maanika/mixed-signal-board/mixed_signal_demo.kicad_pcb

## KiCad design mixed_signal_demo.kicad_pcb (2025-05-20)

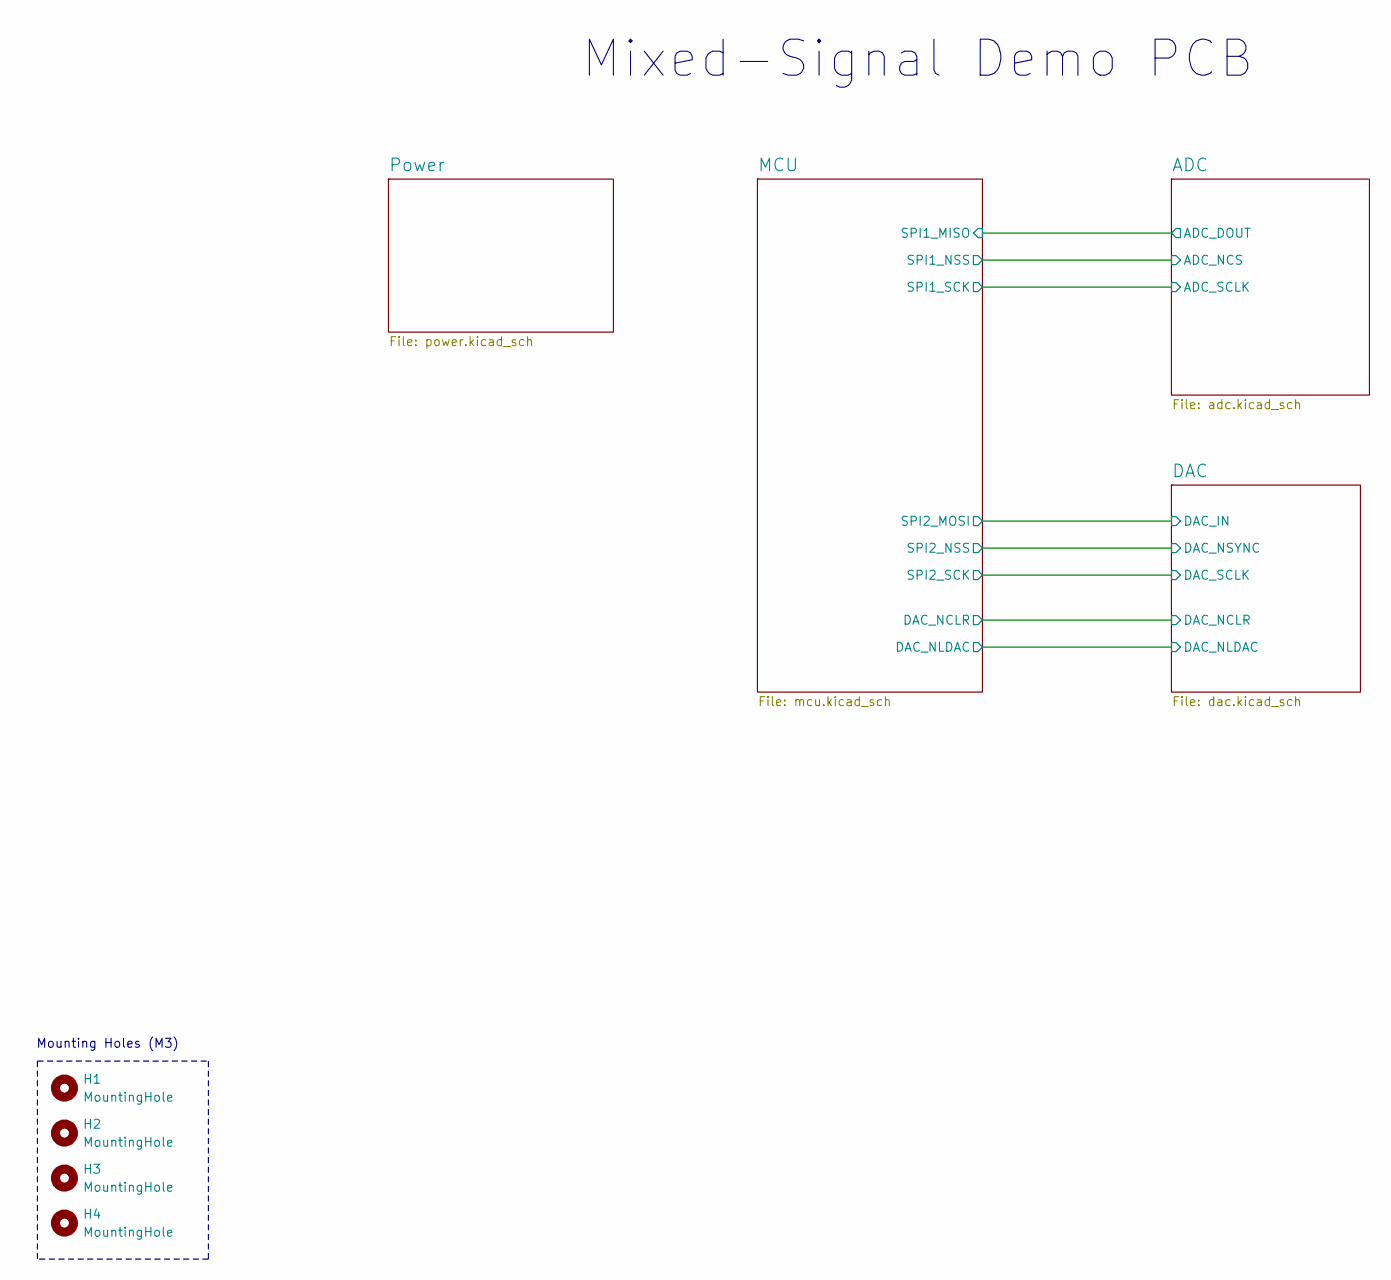
[picture p6: schematic mixed_signal_demo.kicad_sch, Mixed-Signal Demo PCB]

Parts:
H1, H2, H3, H4: MountingHole; MountingHole_3.2mm_M3

Notes on the sheet:
Mixed-Signal Demo PCB
Mounting Holes (M3)

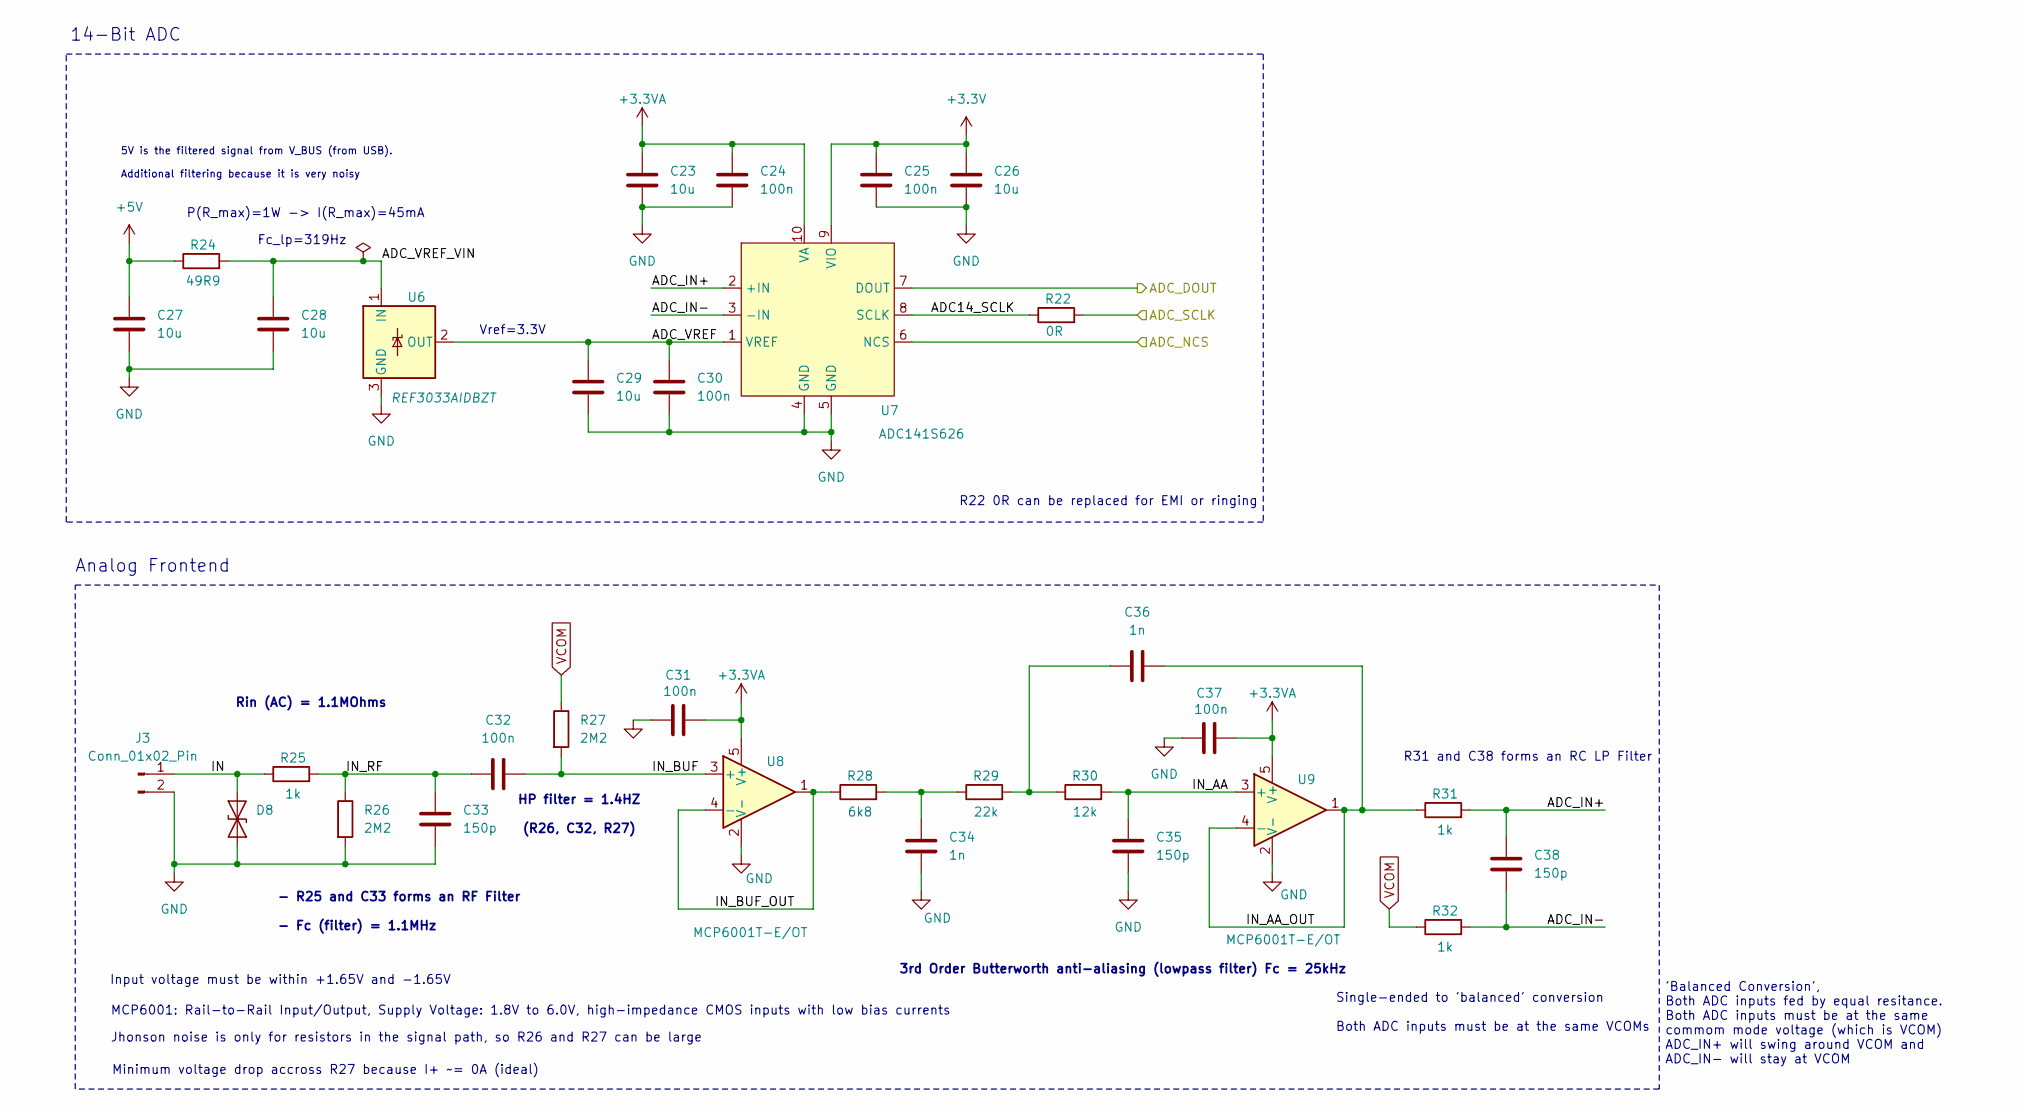
[picture p7: schematic adc.kicad_sch]

Parts:
C23, C26, C27, C28, C29: 10u; C_0603_1608Metric
C24, C25, C30, C31, C32, C37: 100n; C_0402_1005Metric
C33, C35, C38: 150p; C_0402_1005Metric
C34, C36: 1n; C_0402_1005Metric
D8: PESD3V3L1BA; PESD3V3L1BA_SOD-323
J3: Conn_01x02_Pin; PinHeader_1x02_P2.54mm_Vertical
R22: 0R; R_0603_1608Metric
R24: 49R9; R_0805_2012Metric
R25, R31, R32: 1k; R_0402_1005Metric
R26, R27: 2M2; R_0402_1005Metric
R28: 6k8; R_0402_1005Metric
R29: 22k; R_0402_1005Metric
R30: 12k; R_0402_1005Metric
U6: REF3033AIDBZT; SOT-23
U7: ADC141S626; VSSOP-10_3x3mm_P0.5mm
U8, U9: MCP6001T-E/OT; SOT-23-5

Connections:
+3.3V: C25.1, C26.1, U7.9 (VIO); also elsewhere on the board
+3.3VA: C23.1, C24.1, C31.2, C37.2, U7.10 (VA), U8.5 (V+), U9.5 (V+); also elsewhere on the board
+5V: C27.2, R24.1; also elsewhere on the board
/ADC/ADC14_SCLK: R22.1, U7.8 (SCLK)
/ADC/ADC_DOUT: U7.7 (DOUT); also elsewhere on the board
/ADC/ADC_IN+: C38.1, R31.2, U7.2 (+IN)
/ADC/ADC_IN-: C38.2, R32.2, U7.3 (-IN)
/ADC/ADC_NCS: U7.6 (NCS); also elsewhere on the board
/ADC/ADC_SCLK: R22.2; also elsewhere on the board
/ADC/ADC_VREF: C29.2, C30.2, U6.2 (OUT), U7.1 (VREF)
/ADC/ADC_VREF_VIN: C28.1, R24.2, U6.1 (IN)
/ADC/IN: D8.1 (A1), J3.1, R25.1
/ADC/IN_AA: C35.1, R30.2, U9.3 (+)
/ADC/IN_AA_OUT: C36.2, R31.1, U9.1, U9.4 (-)
/ADC/IN_BUF: C32.2, R27.2, U8.3 (+)
/ADC/IN_BUF_OUT: R28.1, U8.1, U8.4 (-)
/ADC/IN_RF: C32.1, C33.1, R25.2, R26.1
GND: C23.2, C24.2, C25.2, C26.2, C27.1, C28.2, C29.1, C30.1, C31.1, C33.2, C34.2, C35.2, C37.1, D8.2 (A2), J3.2, R26.2, U6.3 (GND), U7.4 (GND), U7.5 (GND), U8.2 (V-), U9.2 (V-); also elsewhere on the board
unnamed: C34.1, R28.2, R29.1
unnamed: C36.1, R29.2, R30.1
VCOM: R27.1, R32.1; also elsewhere on the board

Notes on the sheet:
14-Bit ADC
HP filter = 1.4HZ (R26, C32, R27)
'Balanced Conversion', Both ADC inputs fed by equal resitance. Both ADC inputs must be at the same commom mode voltage (which is VCOM) ADC_IN+ will swing around VCOM and ADC_IN- will stay at VCOM
MCP6001: Rail-to-Rail Input/Output, Supply Voltage: 1.8V to 6.0V, high-impedance CMOS inputs with low bias currents
Rin (AC) = 1.1MOhms
Vref=3.3V
P(R_max)=1W -> I(R_max)=45mA
R31 and C38 forms an RC LP Filter
Analog Frontend
Fc_lp=319Hz
3rd Order Butterworth anti-aliasing (lowpass filter) Fc = 25kHz
Single-ended to 'balanced' conversion Both ADC inputs must be at the same VCOMs
5V is the filtered signal from V_BUS (from USB). Additional filtering because it is very noisy
Minimum voltage drop accross R27 because I+ ~= 0A (ideal)
R22 0R can be replaced for EMI or ringing
Input voltage must be within +1.65V and -1.65V
- R25 and C33 forms an RF Filter - Fc (filter) = 1.1MHz
Jhonson noise is only for resistors in the signal path, so R26 and R27 can be large

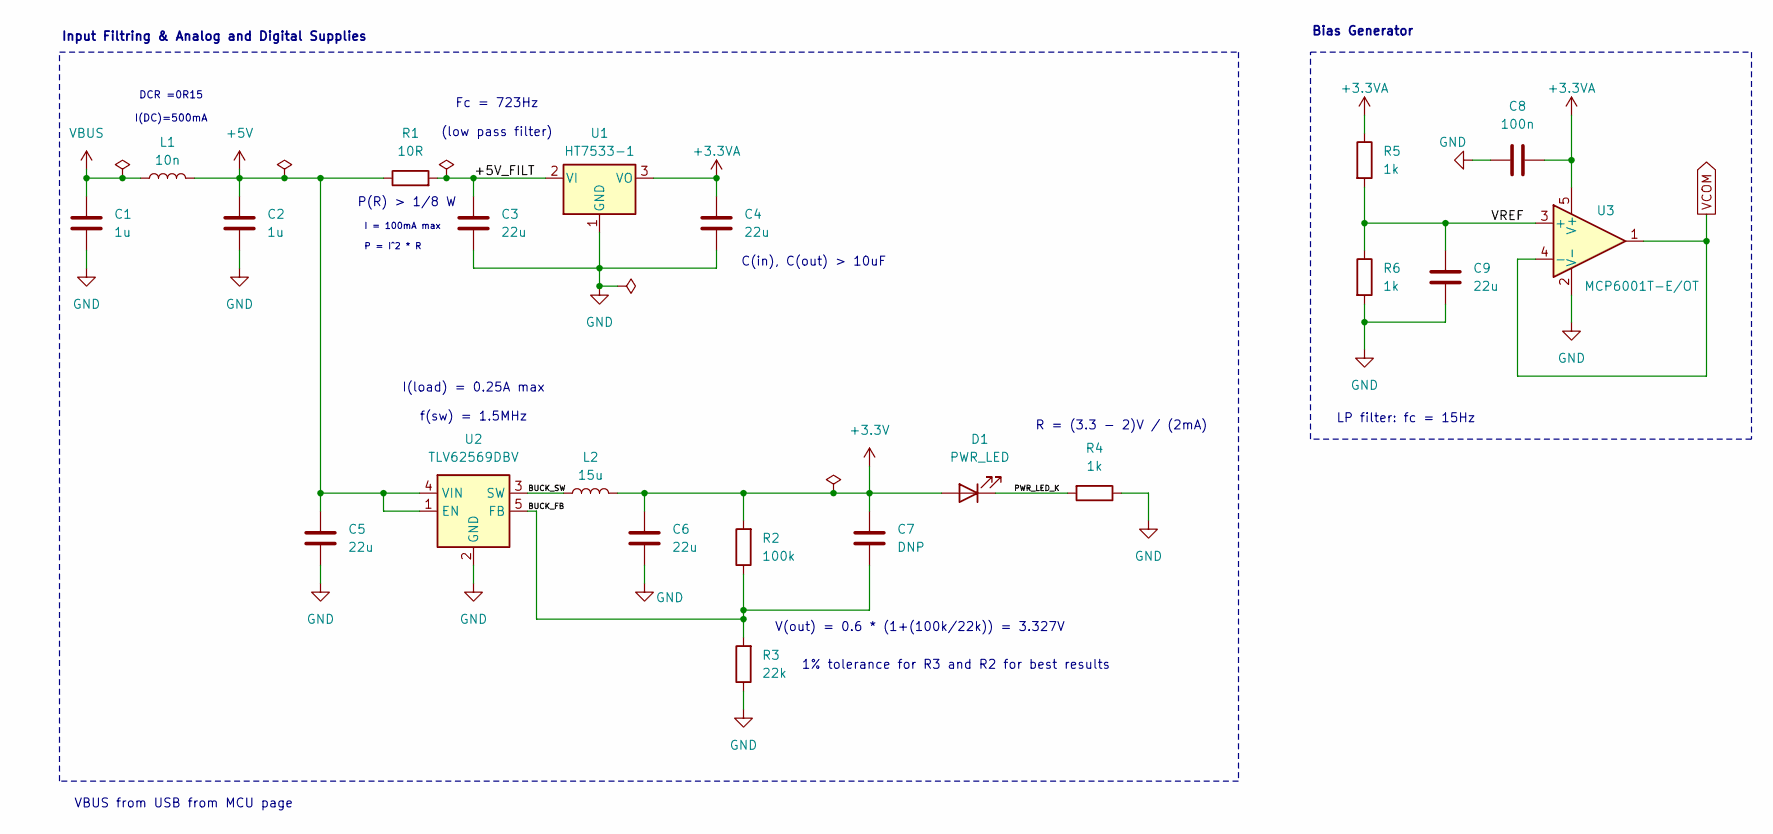
[picture p8: schematic power.kicad_sch, Mixed-Signal Demo PCB]

Parts:
C1, C2: 1u; C_0603_1608Metric
C3, C4, C5, C6, C9: 22u; C_0805_2012Metric
C7: DNP; C_0402_1005Metric
C8: 100n; C_0402_1005Metric
D1: PWR_LED; LED_0603_1608Metric
L1: 10n; L_0603_1608Metric
L2: 15u; L_Coilcraft_XAL4020-XXX
R1: 10R; R_0805_2012Metric
R2: 100k; R_0402_1005Metric
R3: 22k; R_0402_1005Metric
R4, R5, R6: 1k; R_0402_1005Metric
U1: HT7533-1; SOT-89-3
U2: TLV62569DBV; SOT-23-5
U3: MCP6001T-E/OT; SOT-23-5

Connections:
+3.3V: C6.1, C7.1, D1.2 (A), L2.2, R2.2; also elsewhere on the board
+3.3VA: C4.1, C8.2, R5.1, U1.3 (VO), U3.5 (V+); also elsewhere on the board
+5V: C2.1, C5.1, L1.2, R1.1, U2.1 (EN), U2.4 (VIN); also elsewhere on the board
/Power/+5V_FILT: C3.1, R1.2, U1.2 (VI)
/Power/BUCK_FB: C7.2, R2.1, R3.2, U2.5 (FB)
/Power/BUCK_SW: L2.1, U2.3 (SW)
/Power/PWR_LED_K: D1.1 (K), R4.2
/Power/VREF: C9.1, R5.2, R6.1, U3.3 (+)
GND: C1.2, C2.2, C3.2, C4.2, C5.2, C6.2, C8.1, C9.2, R3.1, R4.1, R6.2, U1.1 (GND), U2.2 (GND), U3.2 (V-); also elsewhere on the board
VBUS: C1.1, L1.1; also elsewhere on the board
VCOM: U3.1, U3.4 (-); also elsewhere on the board

Notes on the sheet:
P(R) > 1/8 W
C(in), C(out) > 10uF
DCR =0R15 I(DC)=500mA
I(load) = 0.25A max f(sw) = 1.5MHz
VBUS from USB from MCU page
V(out) = 0.6 * (1+(100k/22k)) = 3.327V
Input Filtring & Analog and Digital Supplies
LP filter: fc = 15Hz
Bias Generator
1% tolerance for R3 and R2 for best results
Fc = 723Hz (low pass filter)
I = 100mA max P = I^2 * R
R = (3.3 - 2)V / (2mA)

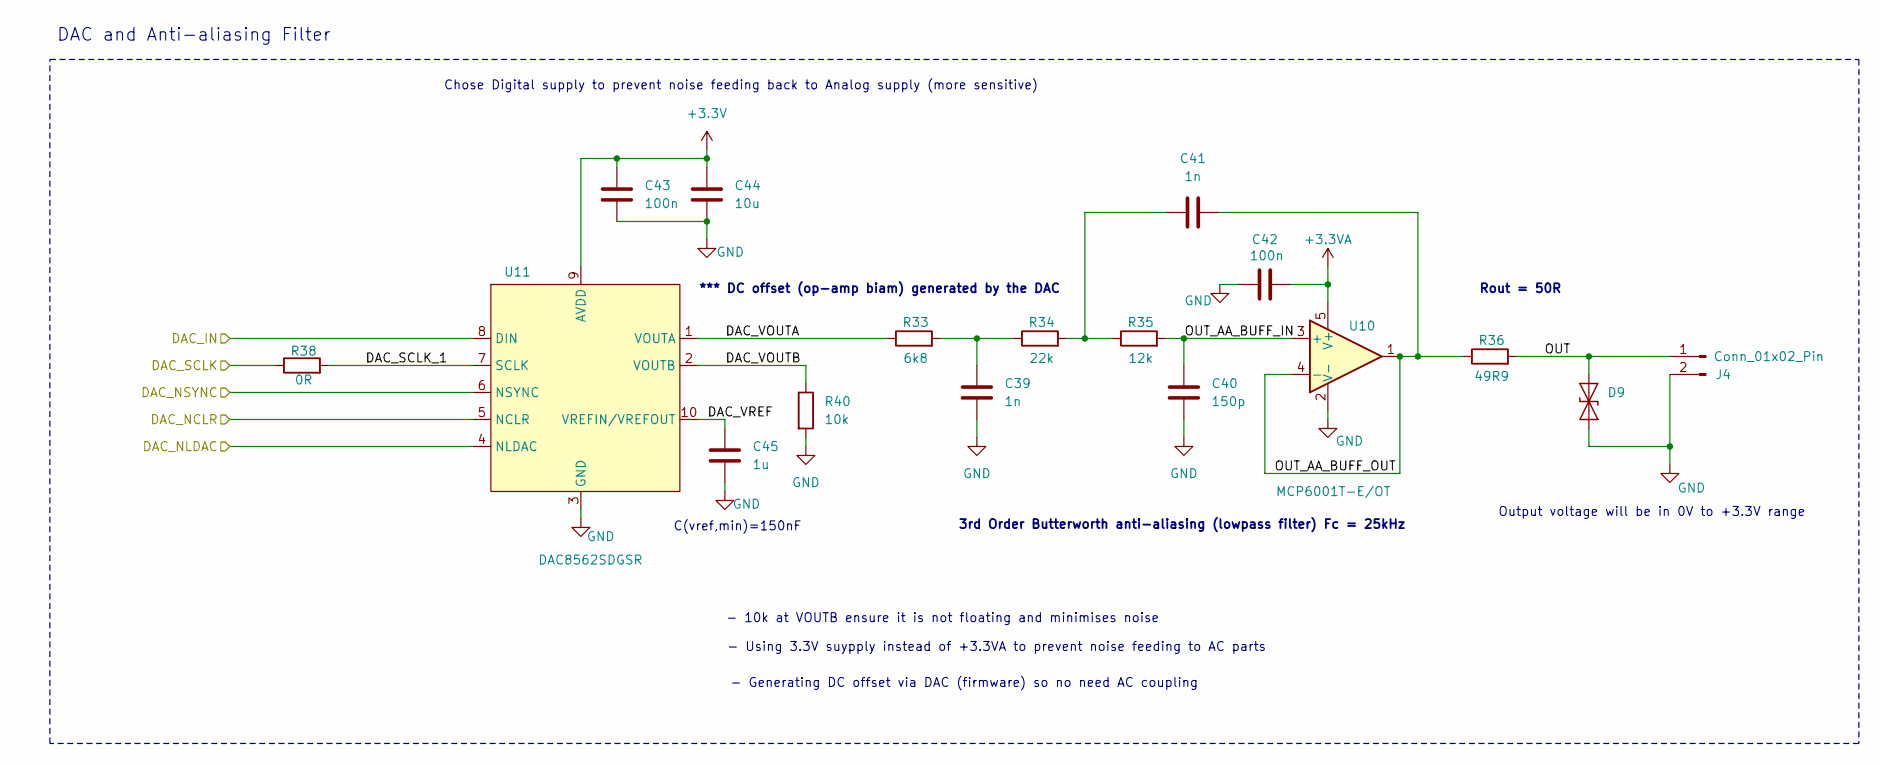
[picture p9: schematic dac.kicad_sch]

Parts:
C39, C41: 1n; C_0402_1005Metric
C40: 150p; C_0402_1005Metric
C42, C43: 100n; C_0402_1005Metric
C44: 10u; C_0603_1608Metric
C45: 1u; C_0603_1608Metric
D9: PESD3V3L1BA; PESD3V3L1BA_SOD-323
J4: Conn_01x02_Pin; PinHeader_1x02_P2.54mm_Vertical
R33: 6k8; R_0402_1005Metric
R34: 22k; R_0402_1005Metric
R35: 12k; R_0402_1005Metric
R36: 49R9; R_0402_1005Metric
R38: 0R; R_0603_1608Metric
R40: 10k; R_0402_1005Metric
U10: MCP6001T-E/OT; SOT-23-5
U11: DAC8562SDGSR; VSSOP-10_3x3mm_P0.5mm

Connections:
+3.3V: C43.1, C44.1, U11.9 (AVDD); also elsewhere on the board
+3.3VA: C42.2, U10.5 (V+); also elsewhere on the board
/DAC/DAC_IN: U11.8 (DIN); also elsewhere on the board
/DAC/DAC_NCLR: U11.5 (NCLR); also elsewhere on the board
/DAC/DAC_NLDAC: U11.4 (NLDAC); also elsewhere on the board
/DAC/DAC_NSYNC: U11.6 (NSYNC); also elsewhere on the board
/DAC/DAC_SCLK: R38.1; also elsewhere on the board
/DAC/DAC_SCLK_1: R38.2, U11.7 (SCLK)
/DAC/DAC_VOUTA: R33.1, U11.1 (VOUTA)
/DAC/DAC_VOUTB: R40.1, U11.2 (VOUTB)
/DAC/DAC_VREF: C45.2, U11.10 (VREFIN/VREFOUT)
/DAC/OUT: D9.1 (A1), J4.1, R36.2
/DAC/OUT_AA_BUFF_IN: C40.1, R35.2, U10.3 (+)
/DAC/OUT_AA_BUFF_OUT: C41.2, R36.1, U10.1, U10.4 (-)
GND: C39.2, C40.2, C42.1, C43.2, C44.2, C45.1, D9.2 (A2), J4.2, R40.2, U10.2 (V-), U11.3 (GND); also elsewhere on the board
unnamed: C39.1, R33.2, R34.1
unnamed: C41.1, R34.2, R35.1

Notes on the sheet:
- Generating DC offset via DAC (firmware) so no need AC coupling
*** DC offset (op-amp biam) generated by the DAC
C(vref,min)=150nF
Chose Digital supply to prevent noise feeding back to Analog supply (more sensitive)
Output voltage will be in 0V to +3.3V range
DAC and Anti-aliasing Filter
3rd Order Butterworth anti-aliasing (lowpass filter) Fc = 25kHz
- Using 3.3V suypply instead of +3.3VA to prevent noise feeding to AC parts
Rout = 50R
- 10k at VOUTB ensure it is not floating and minimises noise

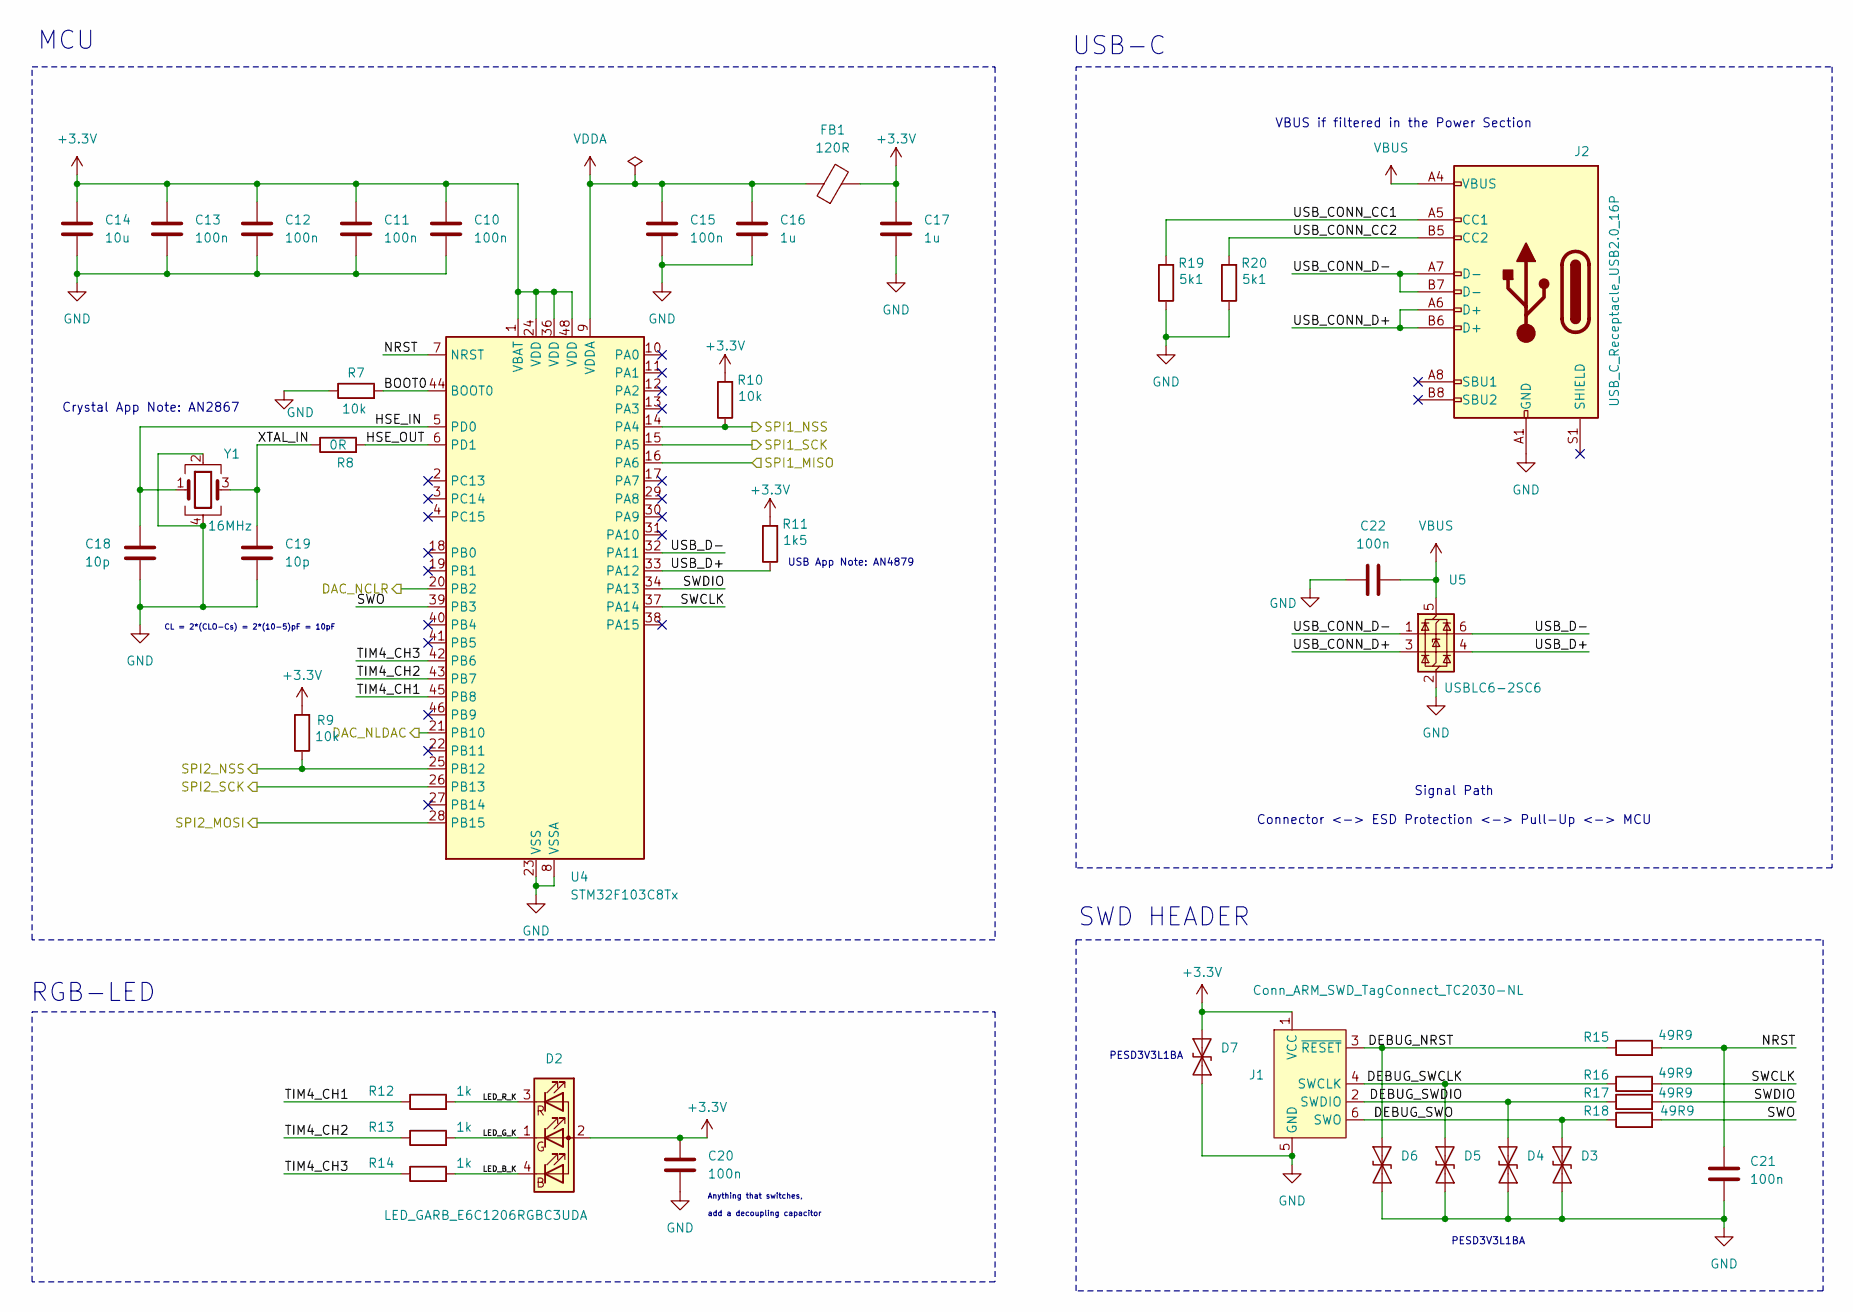
[picture p10: schematic mcu.kicad_sch]

Parts:
C10, C11, C12, C13, C15, C20, C21, C22: 100n; C_0402_1005Metric
C14: 10u; C_0603_1608Metric
C16, C17: 1u; C_0603_1608Metric
C18, C19: 10p; C_0402_1005Metric
D2: LED_GARB_E6C1206RGBC3UDA; LED_RGB_1206
D3, D4, D5, D6, D7: PESD3V3L1BA; PESD3V3L1BA_SOD-323
FB1: 120R; L_0603_1608Metric
J1: Conn_ARM_SWD_TagConnect_TC2030-NL; Tag-Connect_TC2030-IDC-NL_2x03_P1.27mm_Vertical
J2: USB_C_Receptacle_USB2.0_16P; USB_C_Receptacle_G-Switch_GT-USB-7010ASV
R7, R9, R10: 10k; R_0402_1005Metric
R8: 0R; R_0402_1005Metric
R11: 1k5; R_0402_1005Metric
R12, R13, R14: 1k; R_0402_1005Metric
R15, R16, R17, R18: 49R9; R_0402_1005Metric
R19, R20: 5k1; R_0402_1005Metric
U4: STM32F103C8Tx; LQFP-48_7x7mm_P0.5mm
U5: USBLC6-2SC6; SOT-23-6
Y1: 16MHz; Crystal_SMD_3225-4Pin_3.2x2.5mm

Connections:
+3.3V: C10.1, C11.1, C12.1, C13.1, C14.1, C17.1, C20.1, D2.2 (A), D7.1 (A1), FB1.2, J1.1 (VCC), R9.2, R10.2, R11.2, U4.1 (VBAT), U4.24 (VDD), U4.36 (VDD), U4.48 (VDD); also elsewhere on the board
/ADC/ADC_DOUT: U4.16 (PA6); also elsewhere on the board
/ADC/ADC_NCS: R10.1, U4.14 (PA4); also elsewhere on the board
/ADC/ADC_SCLK: U4.15 (PA5); also elsewhere on the board
/DAC/DAC_IN: U4.28 (PB15); also elsewhere on the board
/DAC/DAC_NCLR: U4.20 (PB2); also elsewhere on the board
/DAC/DAC_NLDAC: U4.21 (PB10); also elsewhere on the board
/DAC/DAC_NSYNC: R9.1, U4.25 (PB12); also elsewhere on the board
/DAC/DAC_SCLK: U4.26 (PB13); also elsewhere on the board
/MCU/BOOT0: R7.2, U4.44 (BOOT0)
/MCU/DEBUG_NRST: D6.1 (A1), J1.3 (~RESET), R15.1
/MCU/DEBUG_SWCLK: D5.1 (A1), J1.4 (SWCLK), R16.1
/MCU/DEBUG_SWDIO: D4.1 (A1), J1.2 (SWDIO), R17.1
/MCU/DEBUG_SWO: D3.1 (A1), J1.6 (SWO), R18.1
/MCU/HSE_IN: C18.1, U4.5 (PD0), Y1.1
/MCU/HSE_OUT: R8.2, U4.6 (PD1)
/MCU/LED_B_K: D2.4 (BK), R14.2
/MCU/LED_G_K: D2.1 (GK), R13.2
/MCU/LED_R_K: D2.3 (RK), R12.2
/MCU/NRST: C21.1, R15.2, U4.7 (NRST)
/MCU/SWCLK: R16.2, U4.37 (PA14)
/MCU/SWDIO: R17.2, U4.34 (PA13)
/MCU/SWO: R18.2, U4.39 (PB3)
/MCU/TIM4_CH1: R12.1, U4.45 (PB8)
/MCU/TIM4_CH2: R13.1, U4.43 (PB7)
/MCU/TIM4_CH3: R14.1, U4.42 (PB6)
/MCU/USB_CONN_CC1: J2.A5 (CC1), R19.2
/MCU/USB_CONN_CC2: J2.B5 (CC2), R20.2
/MCU/USB_CONN_D+: J2.A6 (D+), J2.B6 (D+), U5.3 (I/O2)
/MCU/USB_CONN_D-: J2.A7 (D-), J2.B7 (D-), U5.1 (I/O1)
/MCU/USB_D+: R11.1, U4.33 (PA12), U5.4 (I/O2)
/MCU/USB_D-: U4.32 (PA11), U5.6 (I/O1)
/MCU/XTAL_IN: C19.1, R8.1, Y1.3
GND: C10.2, C11.2, C12.2, C13.2, C14.2, C15.2, C16.2, C17.2, C18.2, C19.2, C20.2, C21.2, C22.1, D3.2 (A2), D4.2 (A2), D5.2 (A2), D6.2 (A2), D7.2 (A2), J1.5 (GND), J2.A1 (GND), J2.A12 (GND), J2.B1 (GND), J2.B12 (GND), R7.1, R19.1, R20.1, U4.8 (VSSA), U4.23 (VSS), U4.35 (VSS), U4.47 (VSS), U5.2 (GND), Y1.2, Y1.4; also elsewhere on the board
VBUS: C22.2, J2.A4 (VBUS), J2.A9 (VBUS), J2.B4 (VBUS), J2.B9 (VBUS), U5.5 (VBUS); also elsewhere on the board
VDDA: C15.1, C16.1, FB1.1, U4.9 (VDDA)

Notes on the sheet:
PESD3V3L1BA
Anything that switches, add a decoupling capacitor
USB App Note: AN4879
MCU
CL = 2*(CLO-Cs) = 2*(10-5)pF = 10pF
Crystal App Note: AN2867
USB-C
VBUS if filtered in the Power Section
SWD HEADER
Signal Path Connector <-> ESD Protection <-> Pull-Up <-> MCU
RGB-LED

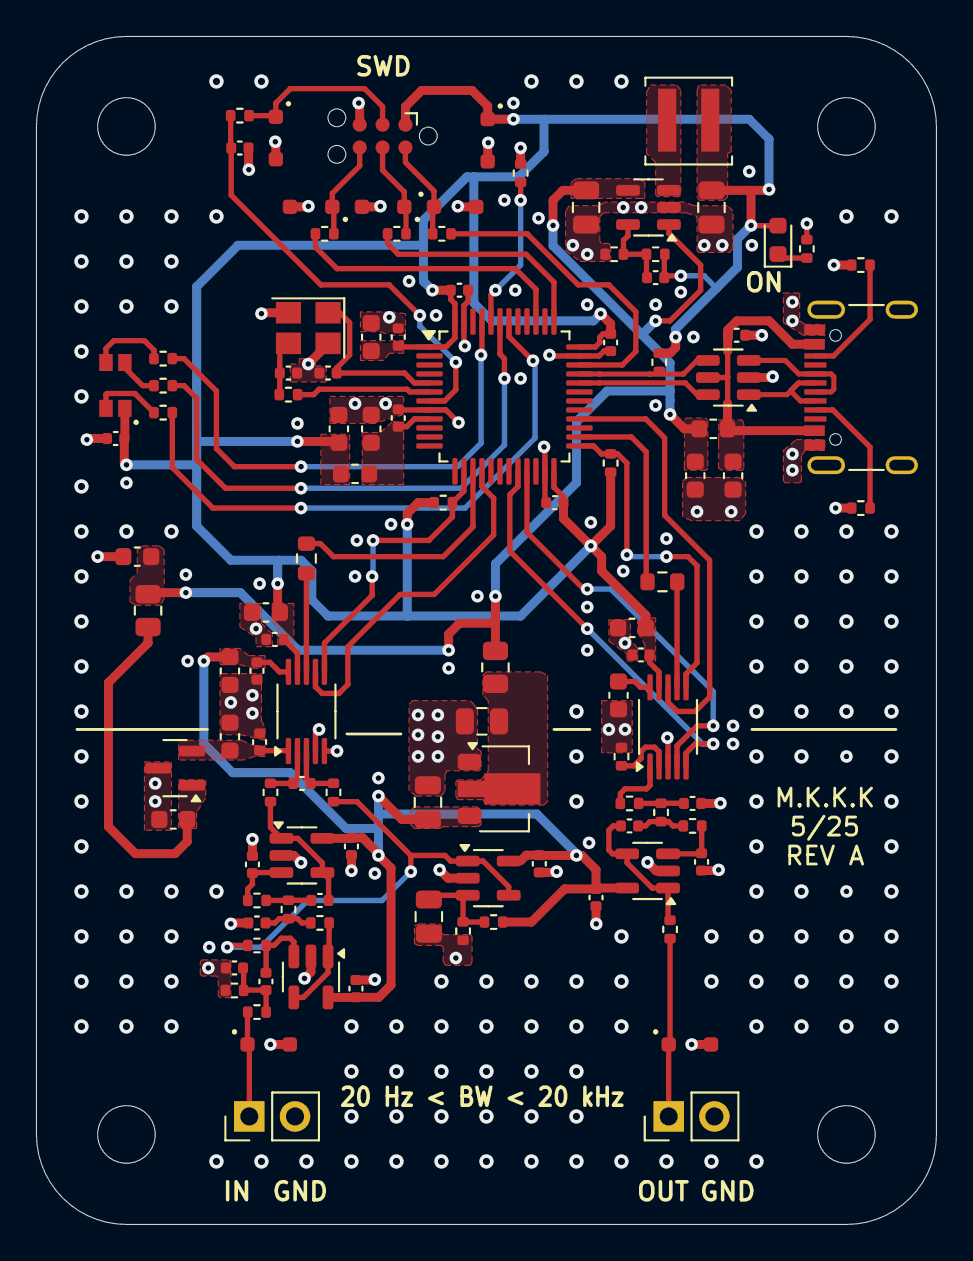
[picture p11: board mixed_signal_demo.kicad_pcb from above]

Board: 4 copper layers, 50.0 x 66.0 mm, 113 parts (0 on the bottom side), 66 nets.
